tomorrow56/M5Stack_DVM/README.md

# M5Stack_DVM

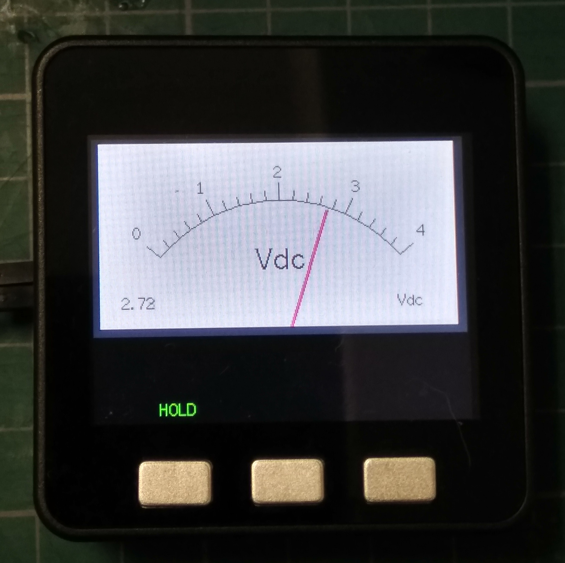
[picture p1: image/DVM.JPG]


M5Stackの内蔵ADCで作るアナログ電圧計です。
M5StackのWi-Fi機能を使って、内蔵A-Dコンバータで測定したデータを電圧に変換してGoogleスプレッドシートに記録するexampleを追加しました。
