tomorrow56/M5Stack_DVM/M5_DVM_data/M5Stack_DVM_parts_list.xlsx

M5Stack_DVK parts list
Name | Kind | Count | Catalog | Price [JPY] | URL | Comment
D10, D11, D20, D21 | Diode | 4 | 1N4148 | 100 | http://akizukidenshi.com/catalog/g/gI-07084/
Q10, Q11, Q20, Q21 | Transistor | 4 | BSS138 | 100 | http://akizukidenshi.com/catalog/g/gI-04232/
SW1 | Switch | 2 | SK-12D01-VG4 | 60 | http://akizukidenshi.com/catalog/g/gP-08789/
R15, R17, R25, R27 | Resistor 1k ohm | 4 | RK73B1JTTD102J | 218 | https://www.chip1stop.com/view/dispDetail/DispDetail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
R16, R18, R26, R28 | Resistor 10k ohm | 4 | RK73B1JTTD103J | 100 | https://www.chip1stop.com/view/dispDetail/DispDetail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
R14, R24 | Resistor 30k ohm | 2 | RK73B1JTTD303J | 134 | https://www.chip1stop.com/view/dispDetail/DispDetail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
R12, R13, R15, R22, R23, R25 | Resistor 100k ohm | 6 | RK73B1JTTD104J | 120 | https://www.chip1stop.com/view/dispDetail/DispDetail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
R11, R21 | Resistor 300k ohm | 2 | RK73B1JTTD304J | 100 | https://www.chip1stop.com/view/dispDetail/DispDetail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
C10, C20 | DNP (Do not Populate) | 0
R1 | DNP (Do not Populate) | 0
M5Stack |  | 1 |  | 3575 | https://www.switch-science.com/catalog/3647/
M5Stack Universal plate |  | 2 |  | 748 | https://www.switch-science.com/catalog/3650/
M5Stack Pin header and socket |  | 1 |  | 1012 | https://www.switch-science.com/catalog/3654/ | 10個入り
