tomorrow56/M5Stack_DVM/3Dprint_case/DVM_8.3mm_0.7mm v2 v3.stl

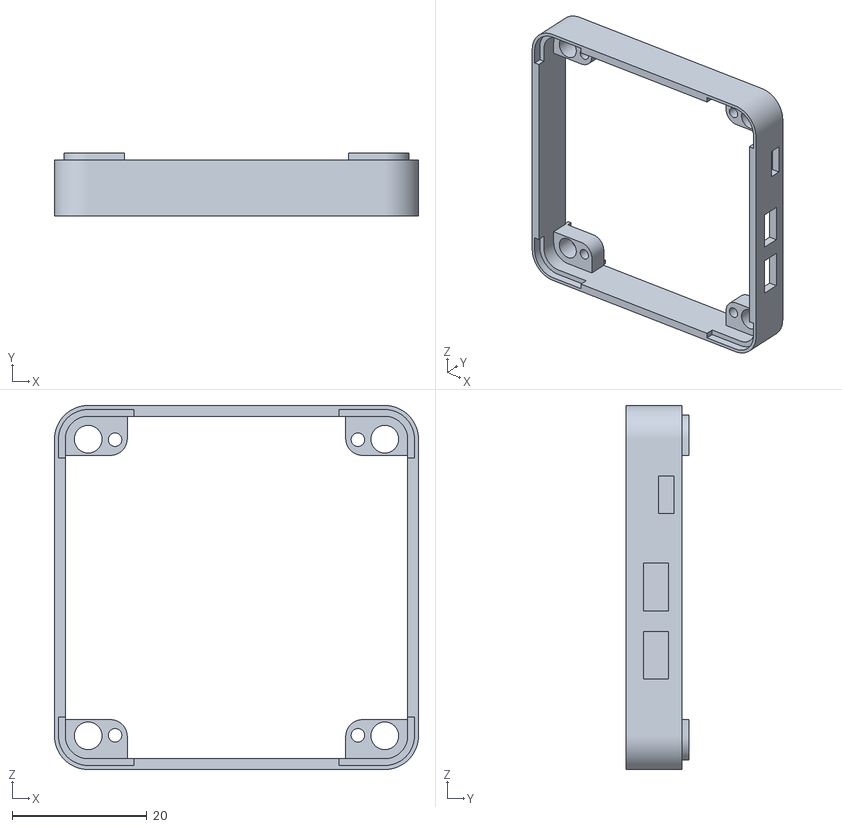
[picture p2: CAD file, 2020-08-13]
3Dprint_case/DVM_8.3mm_0.7mm v2 v3.stl
54.0 x 9.30 x 54.0
