tomorrow56/M5Stack_DVM/M5_DVM_data/M5stack_DVM_issue_1_diode_foot_patrer_more_large.jpg

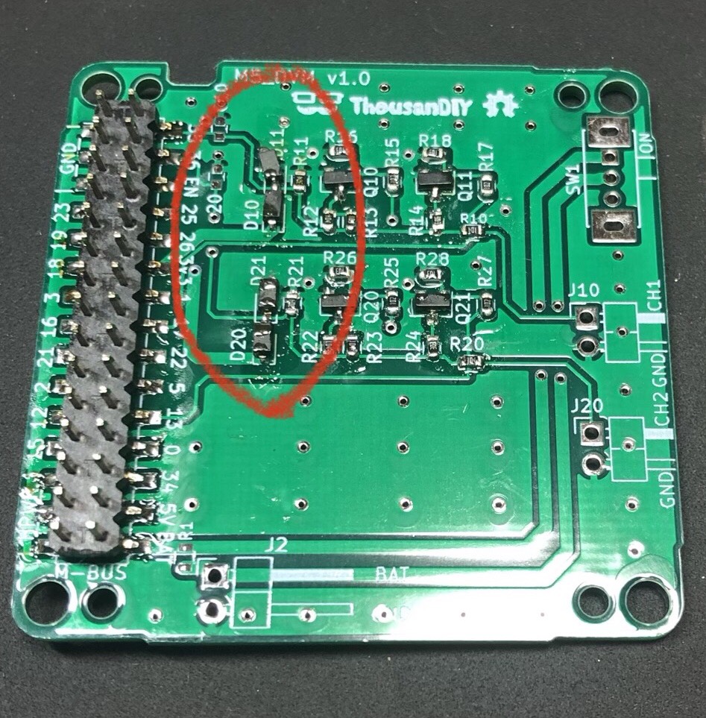
M5_DVM_data/M5stack_DVM_issue_1_diode_foot_patrer_more_large.jpg
