tomorrow56/M5Stack_DVM/(threads)

Thread 3 (2020-07-21):

Diode(1N4148 : D10, D11, D20, D21) foot pattern is more bit large.

takurx, 2020-07-21:
Diode(1N4148 : D10, D11, D20, D21) foot pattern need more bit large.
It's minor error, it can recover for hand.

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

tomorrow56, 2020-07-27:
Thank you for checking.
At the next modification, the macro of the component will be modified.

Closed 2020-07-27.
