tomorrow56/M5Stack_DVM/S5Stack_DVM_schematic.pdf

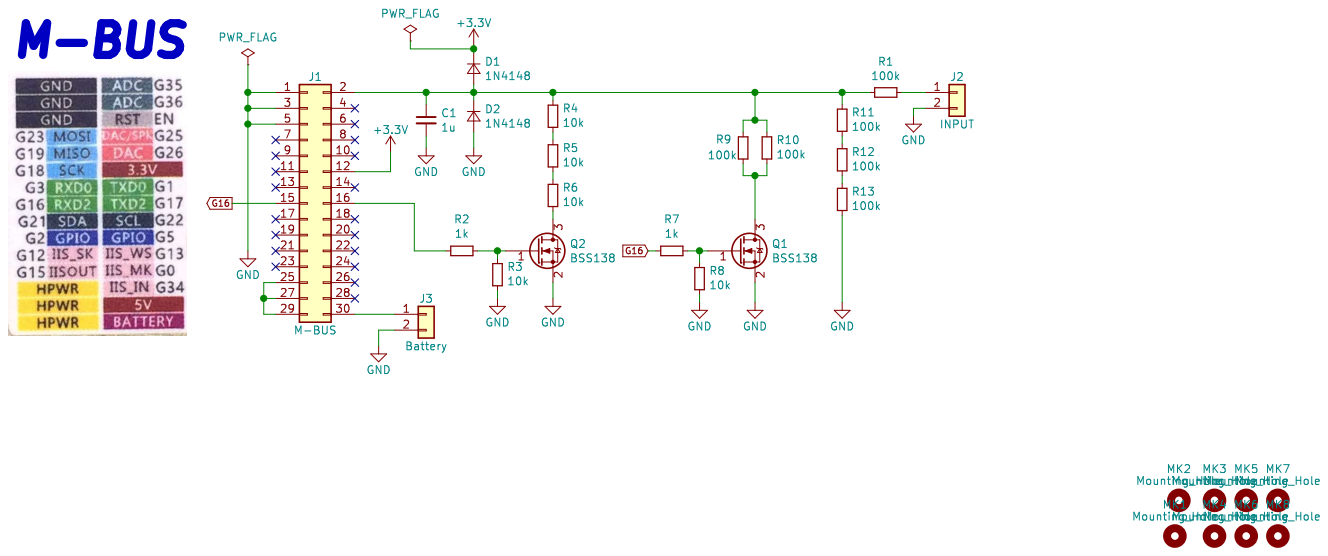
[picture p4: page 1]
