tomorrow56/M5Stack_DVM/KiCad/M5Multimeter_v01/M5Multimeter.kicad_pcb

## KiCad design KiCad/M5Multimeter_v01/M5Multimeter.kicad_pcb (2019-05-28)

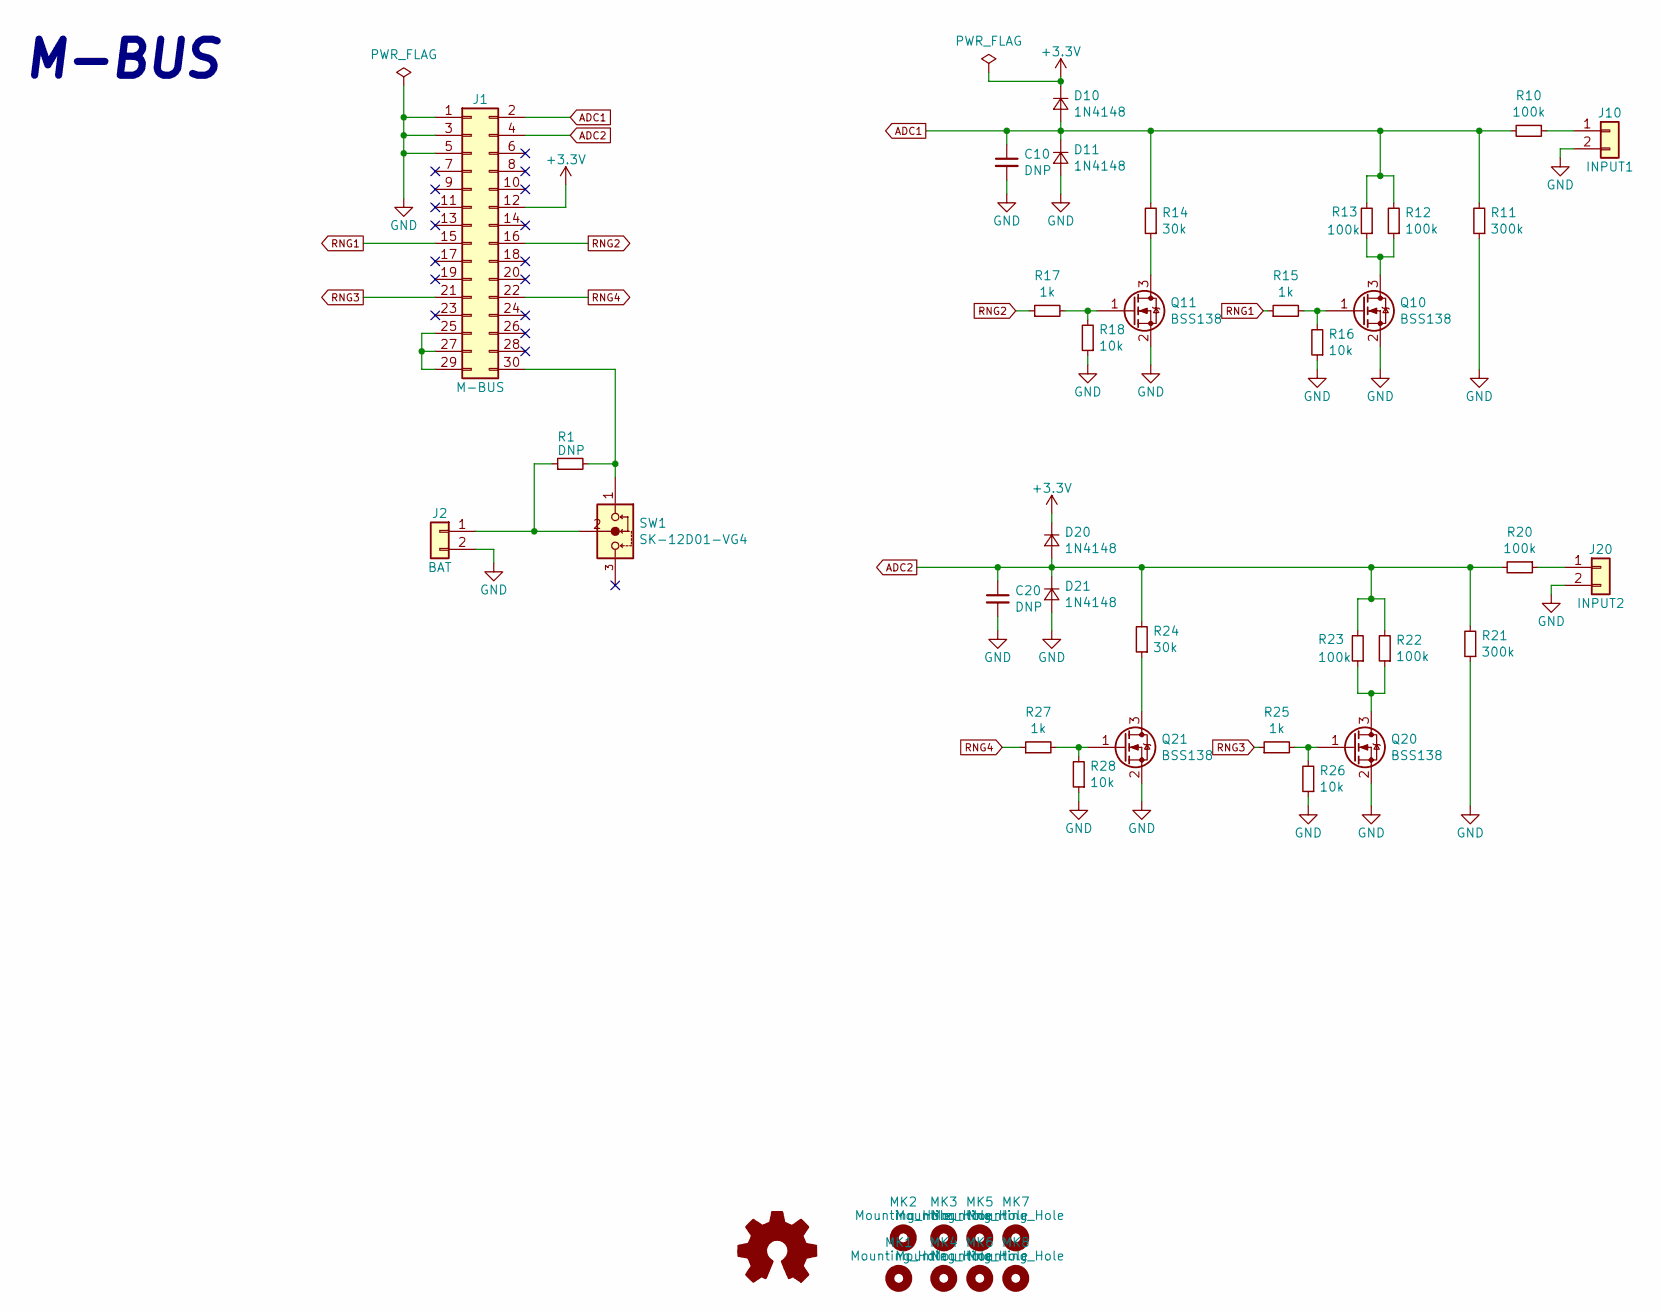
[picture p5: schematic M5Multimeter.sch, M5Stack DVM]

Parts:
C10, C20: DNP; C_0603
D10, D11, D20, D21: 1N4148; D_SOD-323
J1: M-BUS; Pin_Header_MBUS_SMD_TH
J2: BAT; Pin_Header_Angled_1x02_Pitch2.54mm
J10: INPUT1; Pin_Header_Angled_1x02_Pitch2.54mm
J20: INPUT2; Pin_Header_Angled_1x02_Pitch2.54mm
MK1, MK2, MK3, MK4: Mounting_Hole; MountingHole_3.2mm_M3
MK5, MK6, MK7, MK8: Mounting_Hole; MountingHole_2.2mm_M2
Q10, Q11, Q20, Q21: BSS138; SOT-23
R1: DNP; R_0603
R10, R12, R13, R20, R22, R23: 100k; R_0603
R11, R21: 300k; R_0603
R14, R24: 30k; R_0603
R15, R17, R25, R27: 1k; R_0603
R16, R18, R26, R28: 10k; R_0603
SW1: SK-12D01-VG4; slide_switch_angled

Connections:
+3V3: D10.1 (K), D20.1 (K), J1.12
ADC1: C10.1, D10.2 (A), D11.1 (K), J1.2, R10.2, R11.2, R12.2, R13.2, R14.2
ADC2: C20.1, D20.2 (A), D21.1 (K), J1.4, R20.2, R21.2, R22.2, R23.2, R24.2
GND: C10.2, C20.2, D11.2 (A), D21.2 (A), J1.1, J1.3, J1.5, J2.2, J10.2, J20.2, Q10.2 (S), Q11.2 (S), Q20.2 (S), Q21.2 (S), R11.1, R16.1, R18.1, R21.1, R26.1, R28.1
unnamed: J1.25, J1.27, J1.29
unnamed: J1.30, R1.2, SW1.1
unnamed: J2.1, R1.1, SW1.2
unnamed: J10.1, R10.1
unnamed: J20.1, R20.1
unnamed: Q10.1 (G), R15.2, R16.2
unnamed: Q10.3 (D), R12.1, R13.1
unnamed: Q11.1 (G), R17.2, R18.2
unnamed: Q11.3 (D), R14.1
unnamed: Q20.1 (G), R25.2, R26.2
unnamed: Q20.3 (D), R22.1, R23.1
unnamed: Q21.1 (G), R27.2, R28.2
unnamed: Q21.3 (D), R24.1
RNG1: J1.15, R15.1
RNG2: J1.16, R17.1
RNG3: J1.21, R25.1
RNG4: J1.22, R27.1

Notes on the sheet:
M-BUS

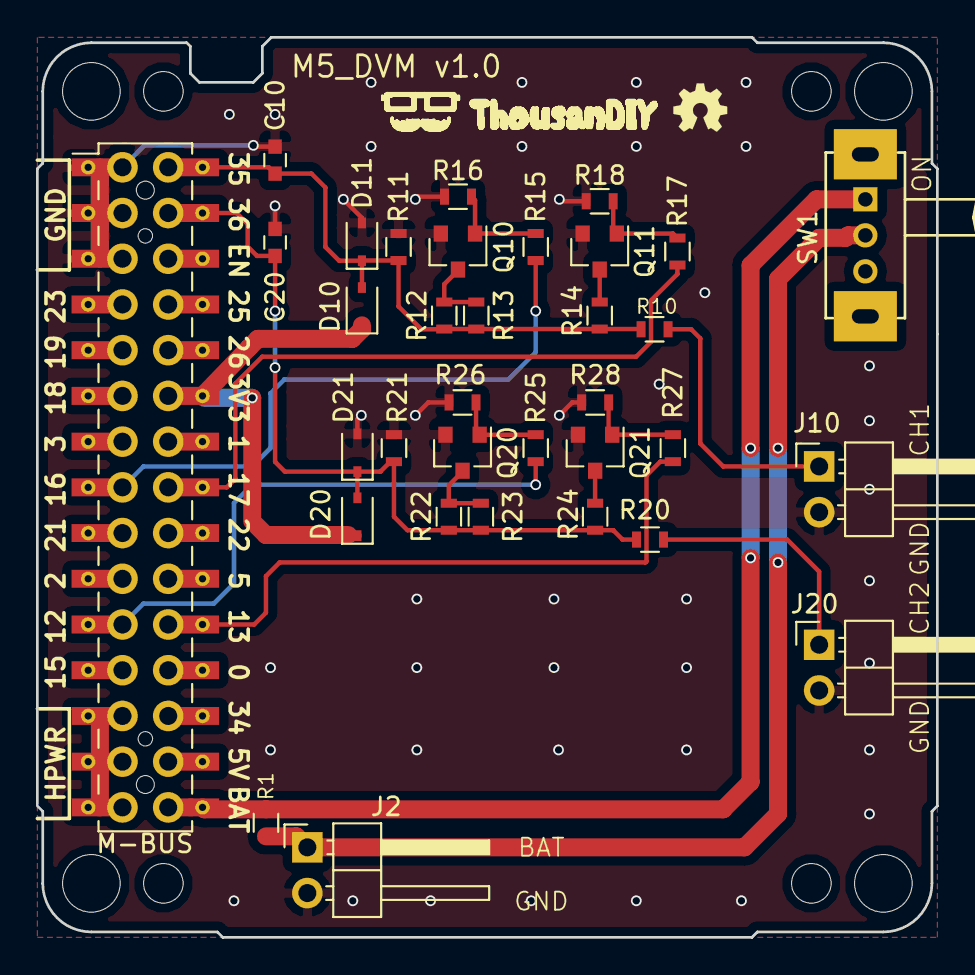
[picture p6: board M5Multimeter.kicad_pcb from above]

Board: 2 copper layers, 50.0 x 50.0 mm, 43 parts (0 on the bottom side), 21 nets.

Other parts of the board:
ref**: val**; TDIY-LOGO-S
