tomorrow56/M5Stack_DVM/(commit log)

2019-01-20 Add schematic
2019-03-31 add PCB design data
    [M5Multimeter.kicad_pcb, M5Multimeter.sch]
2019-05-28 GND / VCC pattern correction
    [M5Multimeter.kicad_pcb]
2020-07-10 add parts list
    add parts list
    [M5Stack_DVM_parts_list.xlsx]
2020-07-11 fix parts list
    fix parts list
    [M5Stack_DVM_parts_list.xlsx]
2020-07-20 fix speaker noise
    fix speaker noise
    https://t-yosh.hatenablog.com/entry/2017/12/28/235947
    [M5Stack_TFT_DCMeter_autorange.ino]
2020-07-21 add photo for description(issue 1) is diode 1N4148 foot pattern more bit
    add photo for description(issue 1) is diode 1N4148 foot pattern more bit large
2020-07-26 configure A/D individual difference
    configure A/D individual difference
    [ESP32_ADC_Charactristics.xlsx, revenge_ESP32_ADC_Charactristics.xlsx]
2020-08-12 add examples
    [M5IFTTT.cfg]
